C-H-Chien/Haptic_Belt_Navigation/EverythingOld/Julian-Valleyeason-May-6-2020-thesis defense.pdf

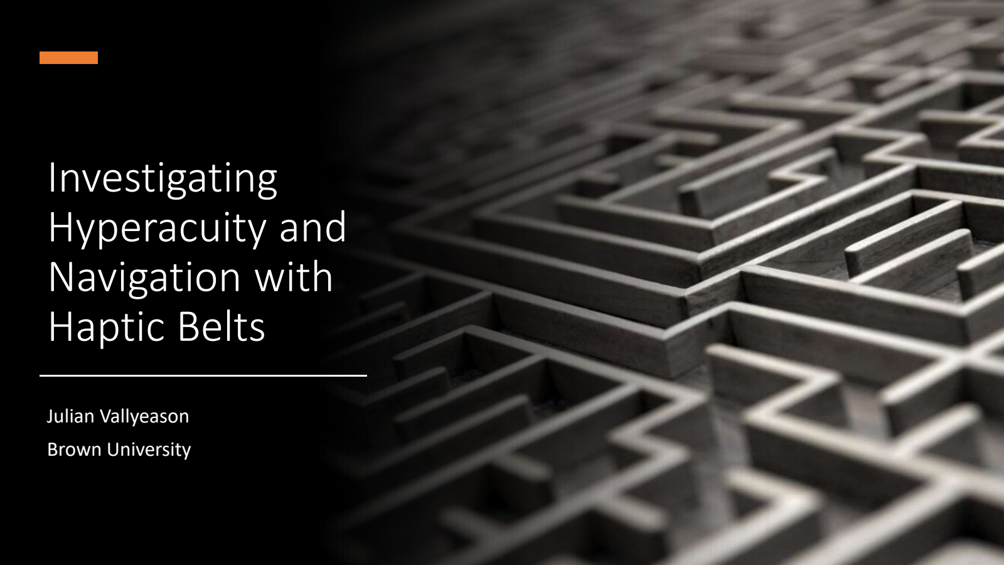
[picture p9: page 1]

# Investigating Hyperacuity and Navigation with Haptic Belts

Julian Vallyeason
Brown University

# Introduction

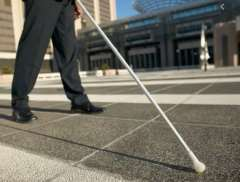
[picture p10: figure]
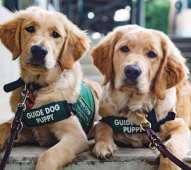
[picture p11: figure]

# Navigational Technologies Considerations

1. Possible intrusion into the existing capacity of a sensory node
2. Difficulty in distilling visual feedback into low-complexity data without information loss
3. Developing an encoding scheme that can be reliably learned and continuously provides sensory feedback
[1] https://thebark.com/content/raising-guide-dog-puppy
[2] https://brailleworks.com/free-white-cane/

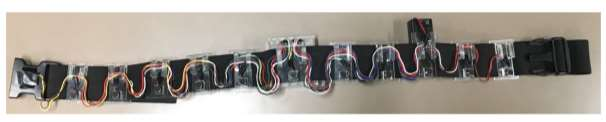
[picture p12: figure]

# Motivating Literature

# •Johannesson

et al.

### - Spatial tactile acuity of motors retained at distances as close as 13 mm apart

### - 92% accuracy for separations of 30 mm

# •Cholewiak et

al.

### - Examined detection threshold for vibration on 12 sites around the abdomen - People tend to interpret vibrations ‘relative to specific loci around the body’ (spine & navel)

•Pielot et al.

### - Individuals can interpolate vibrations of different intensities around their waist

Johannesson, O. I., Hoffmann, R., Valgeirsdottir, V. V., Unnoorsson, R., Moldoveanu, A., & Kristjonsson, .. (2017). Relative vibrotactile spatial acuity of the torso. Experimental brain research, 235(11), 3505–3515. https://doi.org/10.1007/s00221-017-5073-6

Cholewiak, Roger W., et al. “Vibrotactile Localization on the Abdomen: Effects of Place and Space.” Perception & Psychophysics, vol. 66, no. 6, 2004, pp. 970–987., doi:10.3758/bf03194989.

Pielot, Martin, et al. “Evaluation of Continuous Direction Encoding with Tactile Belts.” Haptic and Audio Interaction Design Lecture Notes in Computer Science, 2008, pp. 1–10., doi:10.1007/978-3-540-87883-4_1.

## Objective

Investigate the effect of
haptic belt motor density
and vibration strength on
vibratory perception of
direction

Examine the efficiency of
single-motor vs. vibrating a distribution of motors at
varying intensities

How are vibratory
perceptions translated into directions and navigation?

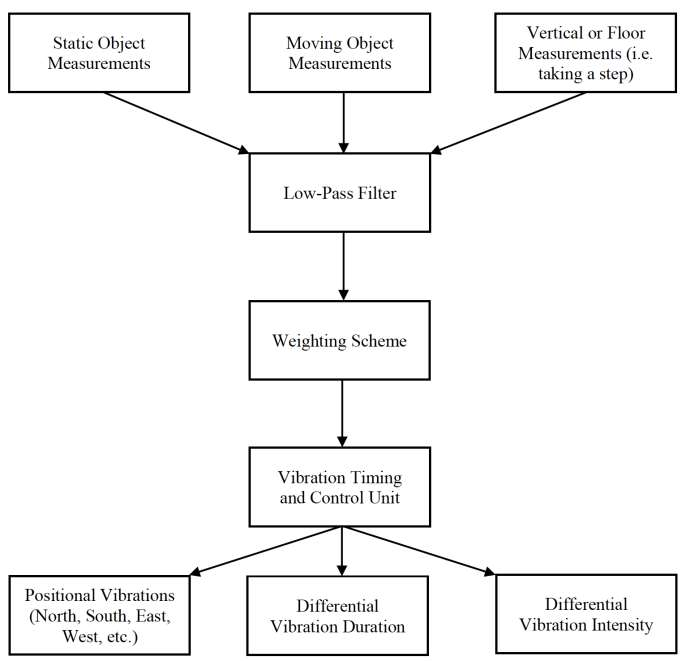
[picture p13: figure]

Adapted from; Katzschmann, R. K., Araki, B., & Rus, D. (2018). Safe Local Navigation for Visually Impaired Users with a Time-of-Flight and Haptic Feedback Device. IEEE Transactions on Neural Systems and Rehabilitation Engineering, 26 (3), 583–593. doi: 10.1109/tnsre.2018.2800665

Test 1: Vibratory Perception Test 2: Discrete Control
Test 3: Continuous Feedback

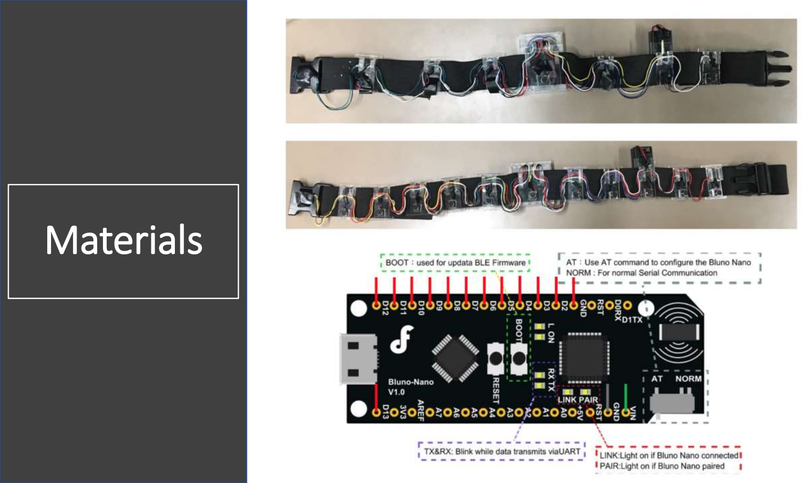
[picture p14: page 5]

# Materials

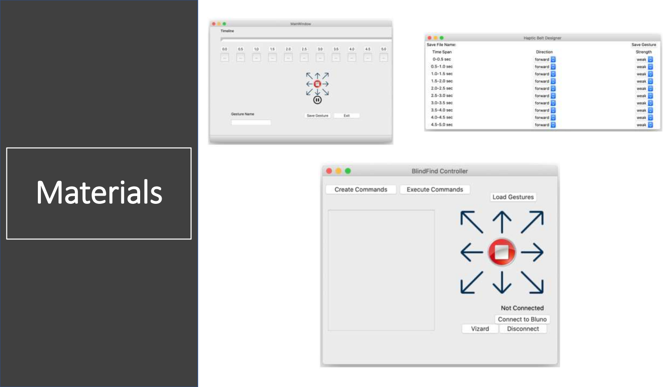
[picture p15: page 6]

# Materials

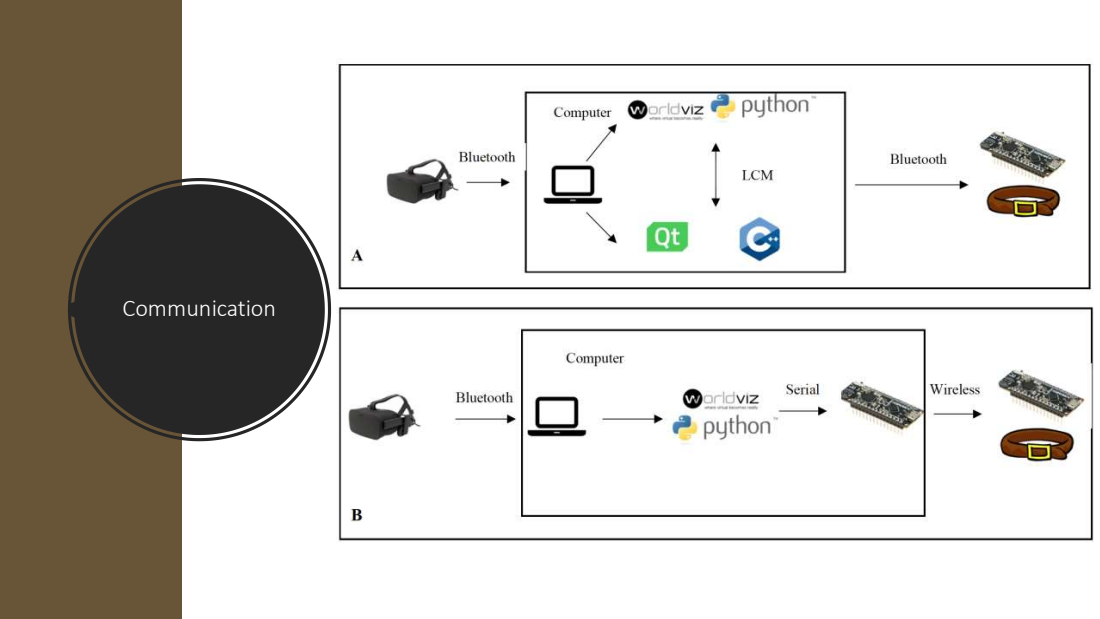
[picture p16: page 7]
Communication

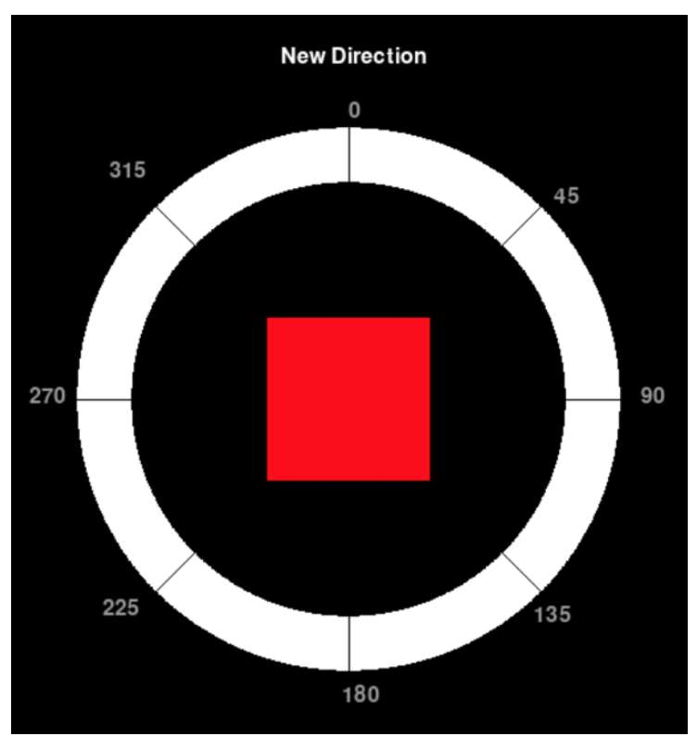
[picture p17: figure]

# Test 1: Vibratory Perception

- Examine single-motor
vibration (8-motor and 12-motor belt) and Gaussian
vibration scheme (12-motor belt)
- Subjects were told to click on the direction they feel best represents the
direction of vibration

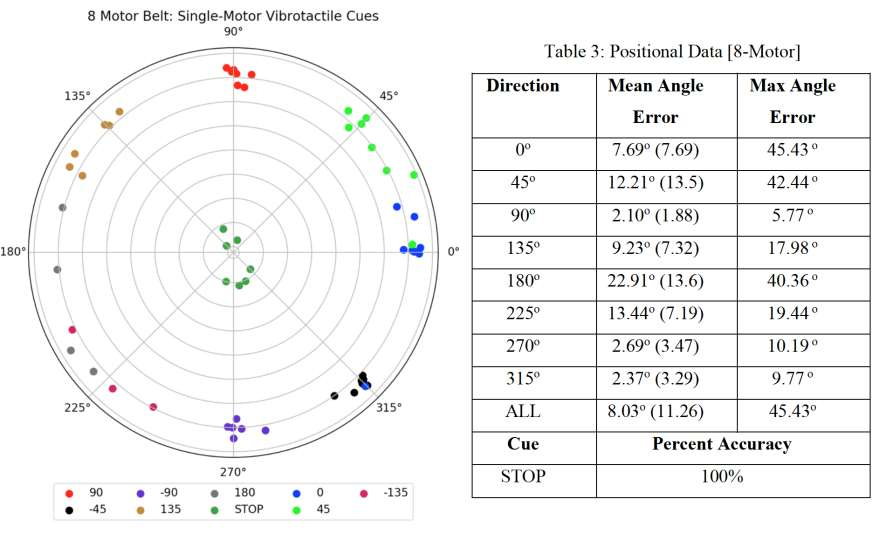
[picture p18: figure]

8-Motor Belt
Single-Motor Vibrations

# Test 1: Vibratory Perception

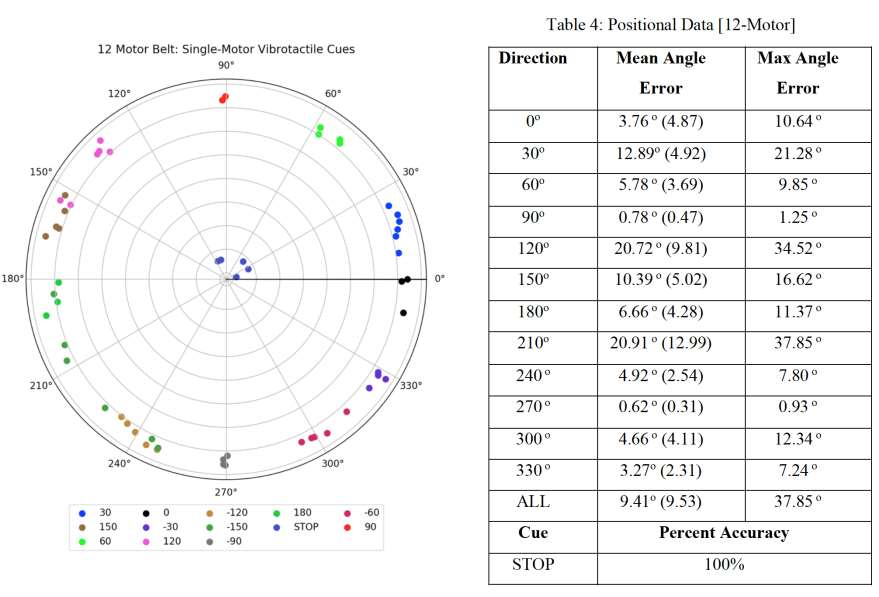
[picture p19: figure]

12-Motor Belt
Single-Motor Vibrations

# Test 1: Vibratory Perception

# Test 1: Vibratory

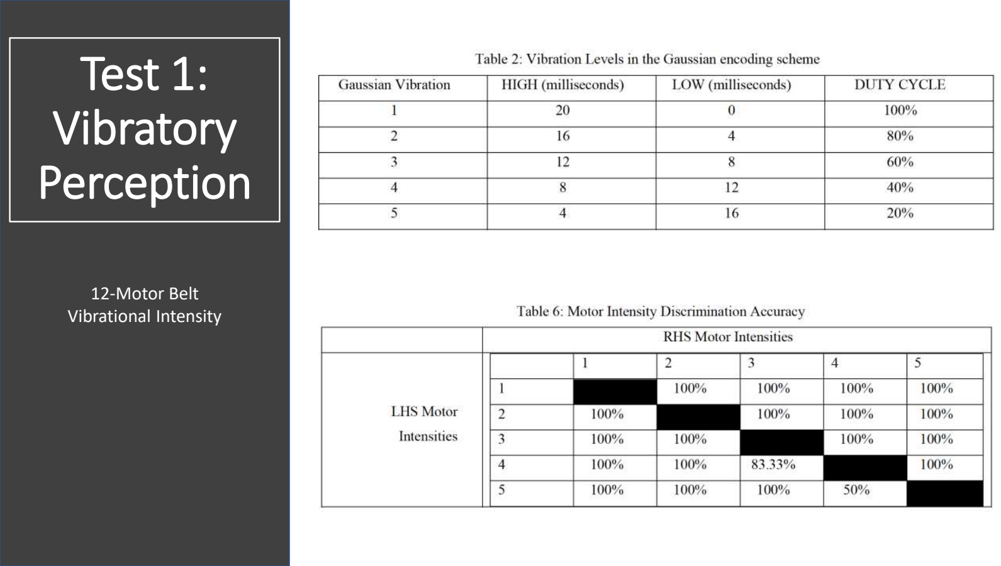
[picture p20: page 11]

# Perception

12-Motor Belt
Vibrational Intensity

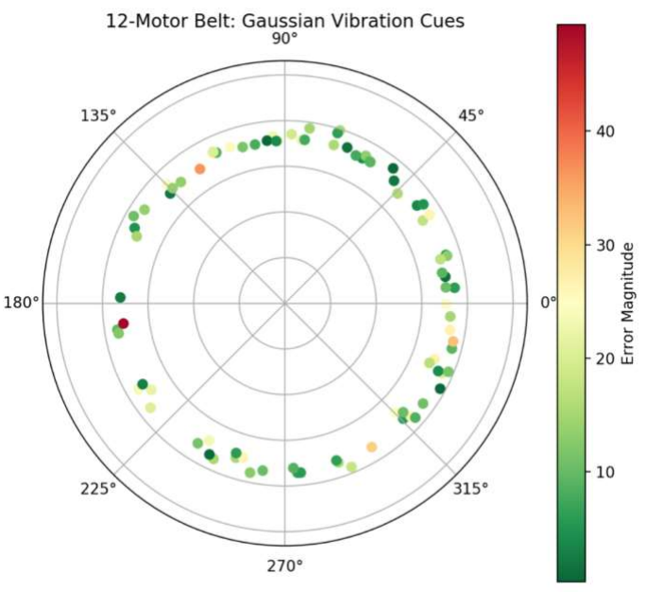
[picture p21: figure]

# Test 1: Vibratory Perception

12-Motor Belt
Gaussian Vibration Scheme

# Test 1:

# Vibratory Perception (Summary)

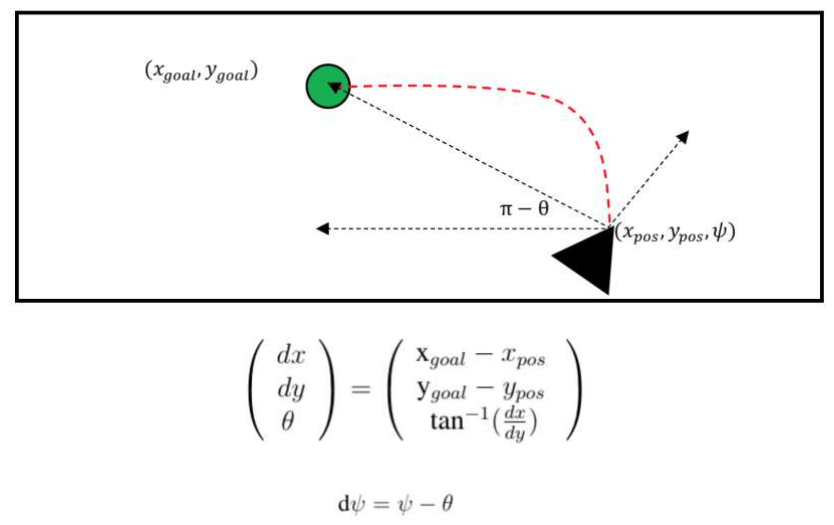
[picture p22: figure]

## 2) Discrete Control

## 3) Continuous Feedback

# Navigation Methods

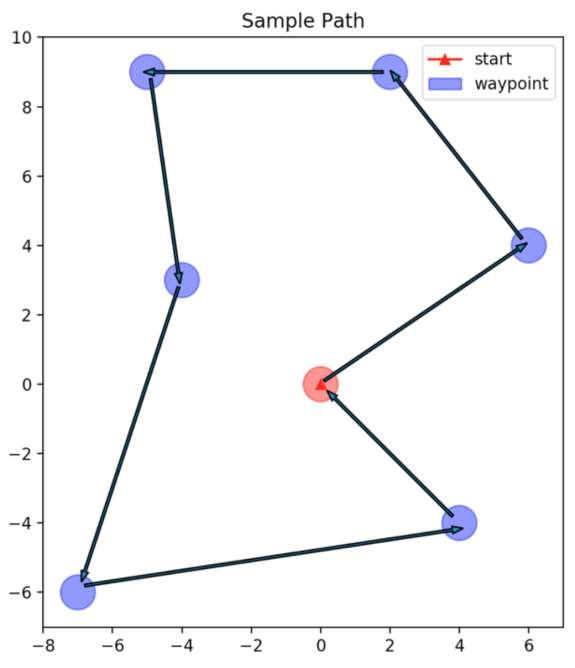
[picture p23: figure]

# Test 2: Discrete Control

- Navigate to 7 waypoints
receiving only an initial
signal from the current
point
- Keyboard-based navigation in virtual reality (W-A-S-D)

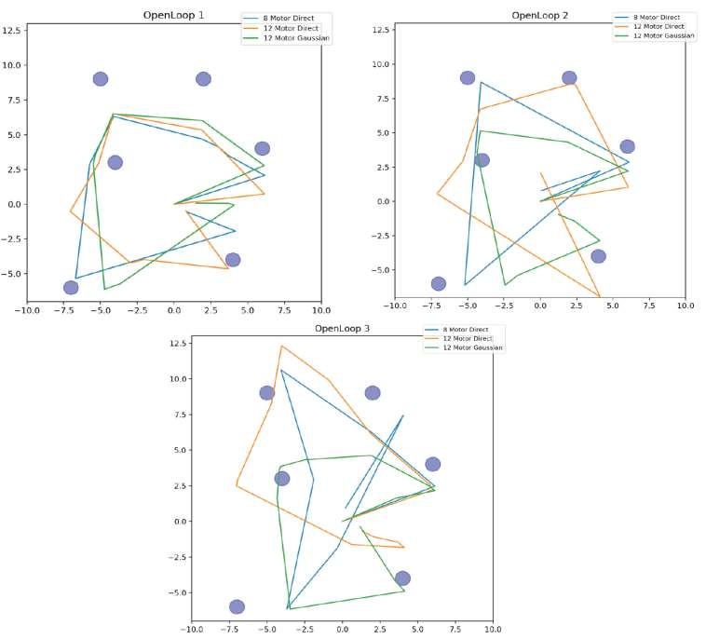
[picture p24: figure]

# Test 2: Discrete Control

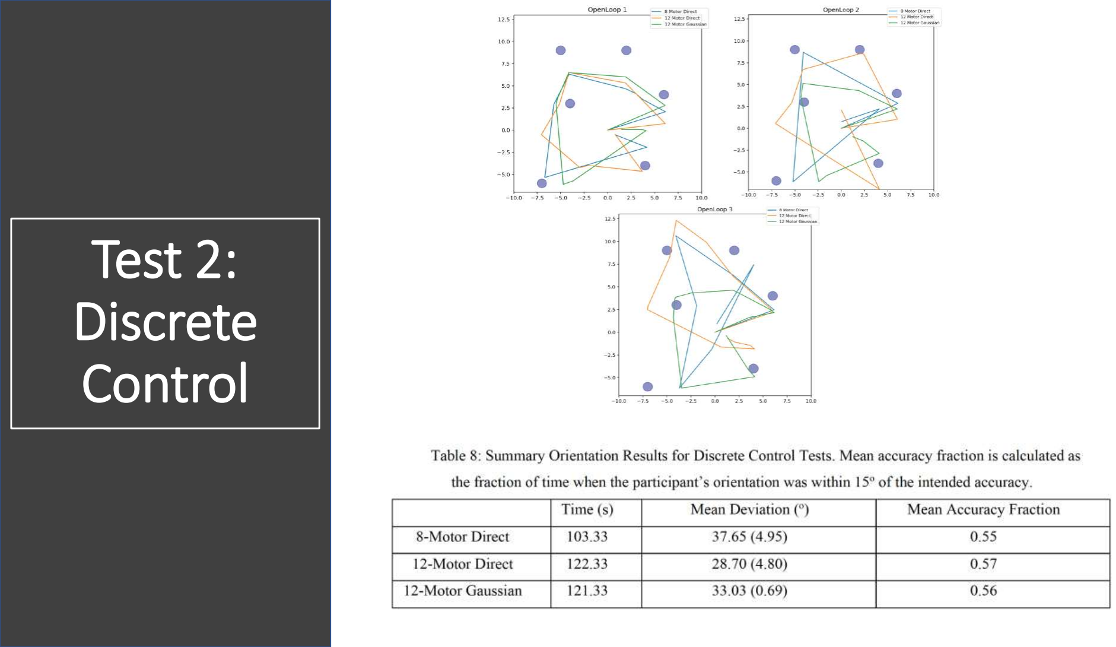
[picture p25: page 17]

# Test 2: Discrete Control

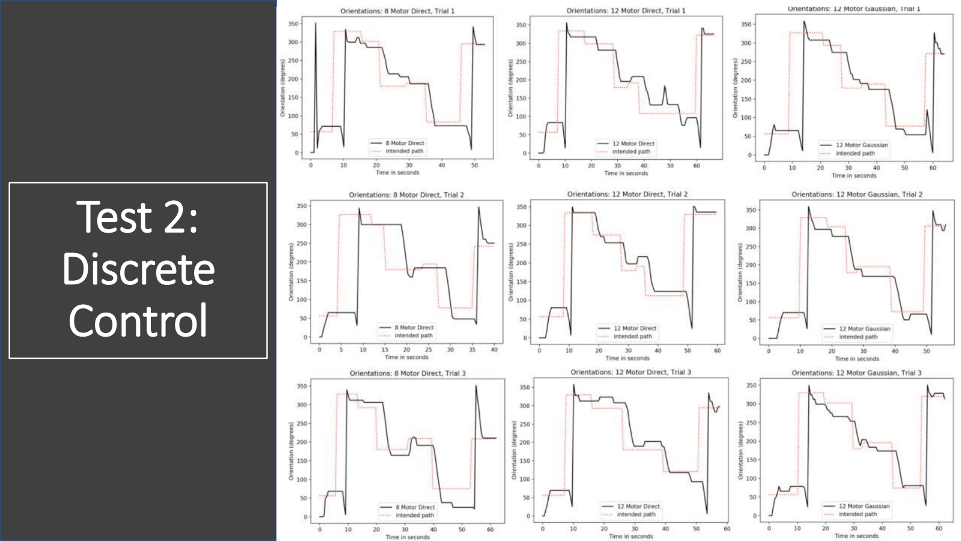
[picture p26: page 18]

# Test 2: Discrete Control

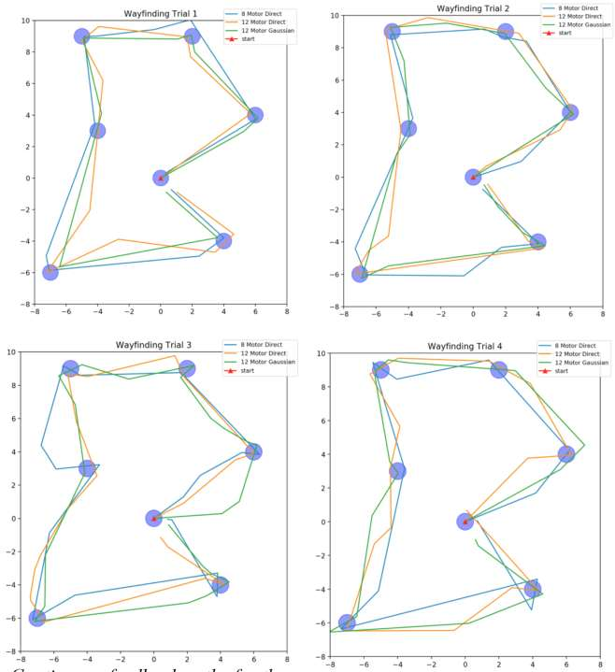
[picture p27: figure]

# Test 3: Continuous Feedback

- Continuously send
navigational vibrations
every 0.4 seconds
- Keyboard-based navigation in virtual reality (W-A-S-D)

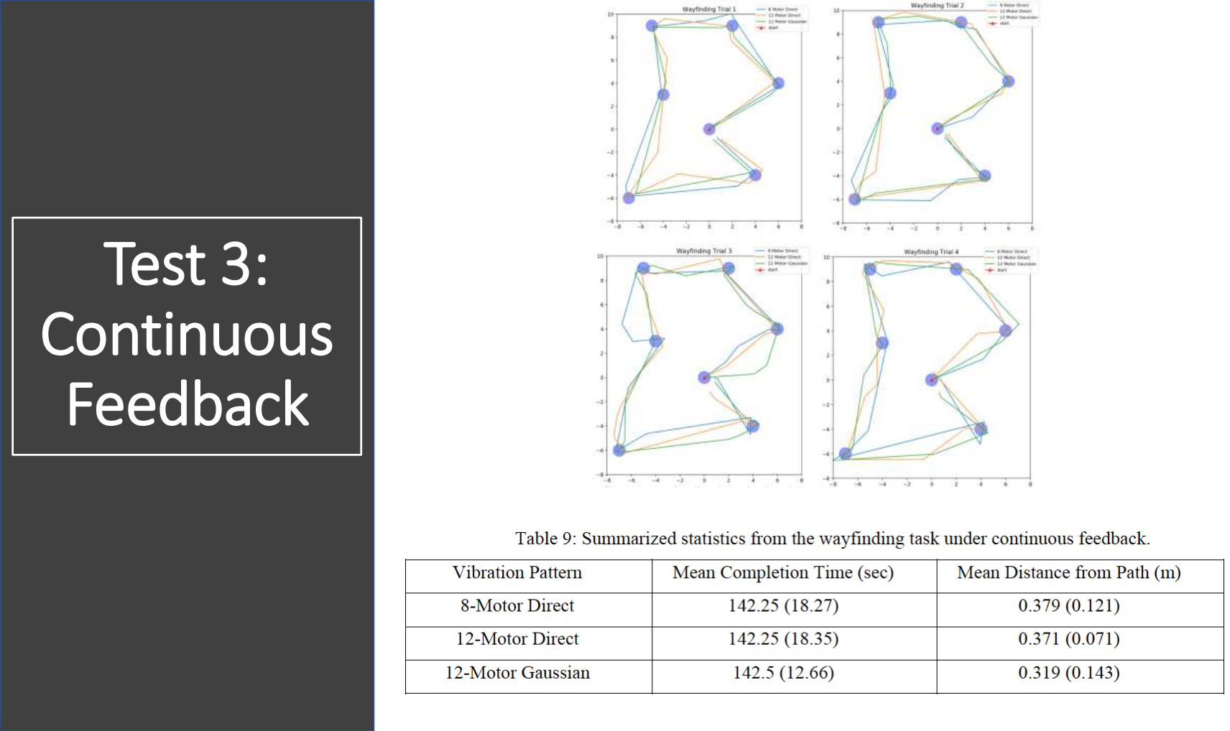
[picture p28: page 20]

# Test 3: Continuous Feedback

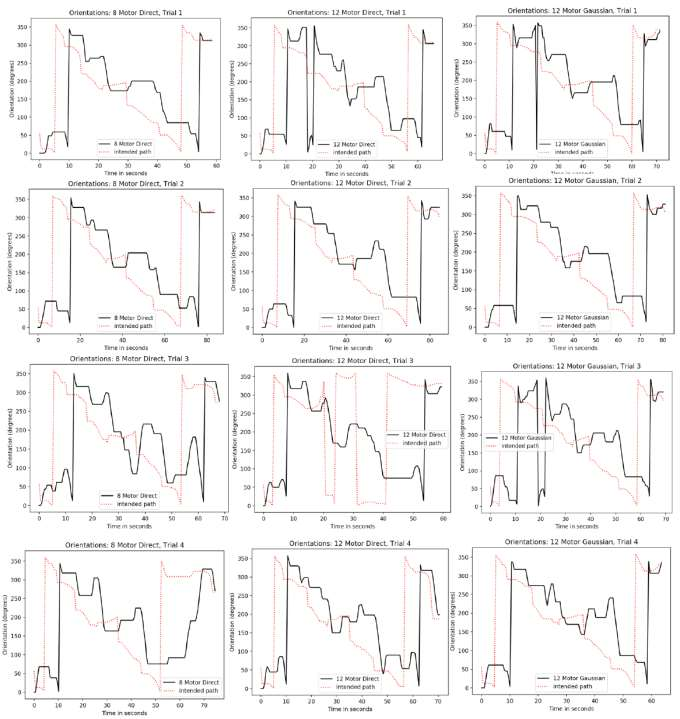
[picture p29: figure]

# Test 3: Continuous Feedback

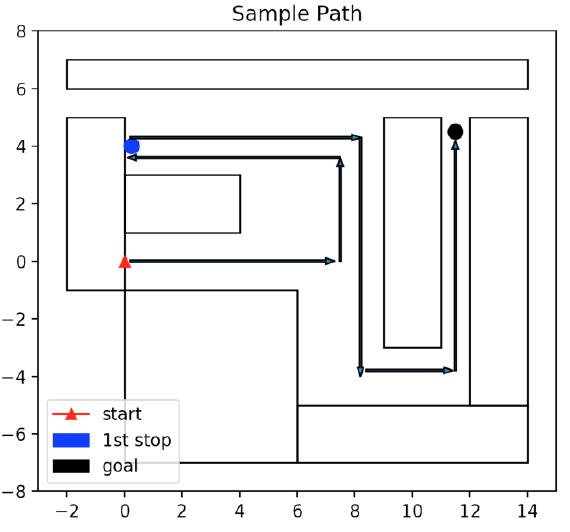
[picture p30: figure]

# Test 3: Continuous Feedback (2nd Task)

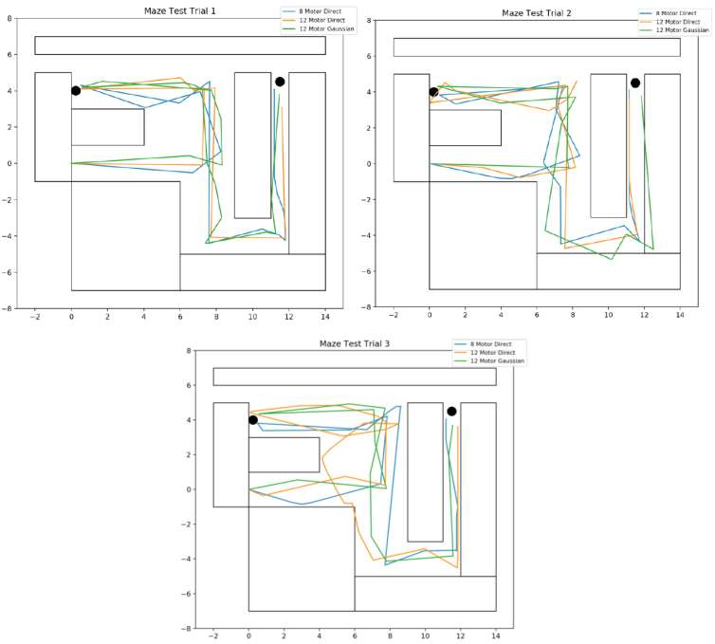
[picture p31: figure]

# Test 3: Continuous Feedback (2nd Task)

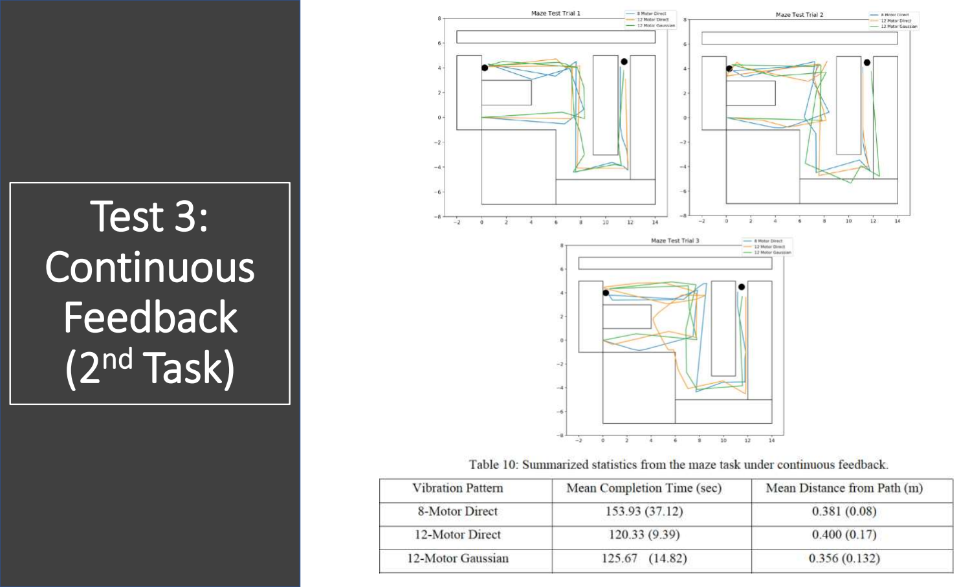
[picture p32: page 24]

# Test 3: Continuous Feedback (2nd Task)

# Conclusions

Investigate the effect of haptic belt motor density and vibration strength on vibratory perception of direction

Examine the efficiency of single-motor vs. vibrating a distribution of motors at varying intensities

How are vibratory perceptions translated into directions and navigation?

We see a slightly higher level of perception error with higher motor density,
but we have the ability to specify a wider range of directions.

The Gaussian vibration scheme appears to be comparable to the single-motor vibration scheme. Its performance led to a slightly lower distance error in the wayfinding task.

Vibratory perceptions can be translated into navigable directions. However, factors such as turning lag and persistent errors must be corrected.

## - Rotate the belt to different orientations to further test perception results - Effects of turning lag - Correction for persistent errors:

## - High waypoint density - 2 separate navigational schemes

- Incremental Turning Control
- Unguided Turning Control

## - 16-motor belt

# Future Steps

## - Viktor Ladics - Hongyi Fan - Dr. Brian Free - Professor Benjamin Kimia - LEMS and VEN lab

# Acknowledgements

# Investigating Hyperacuity and Navigation with Haptic Belts

## Julian Vallyeason Brown University
