C-H-Chien/Haptic_Belt_Navigation/Experiments/Navigation/00_Instructions/Open-ended-questions.png

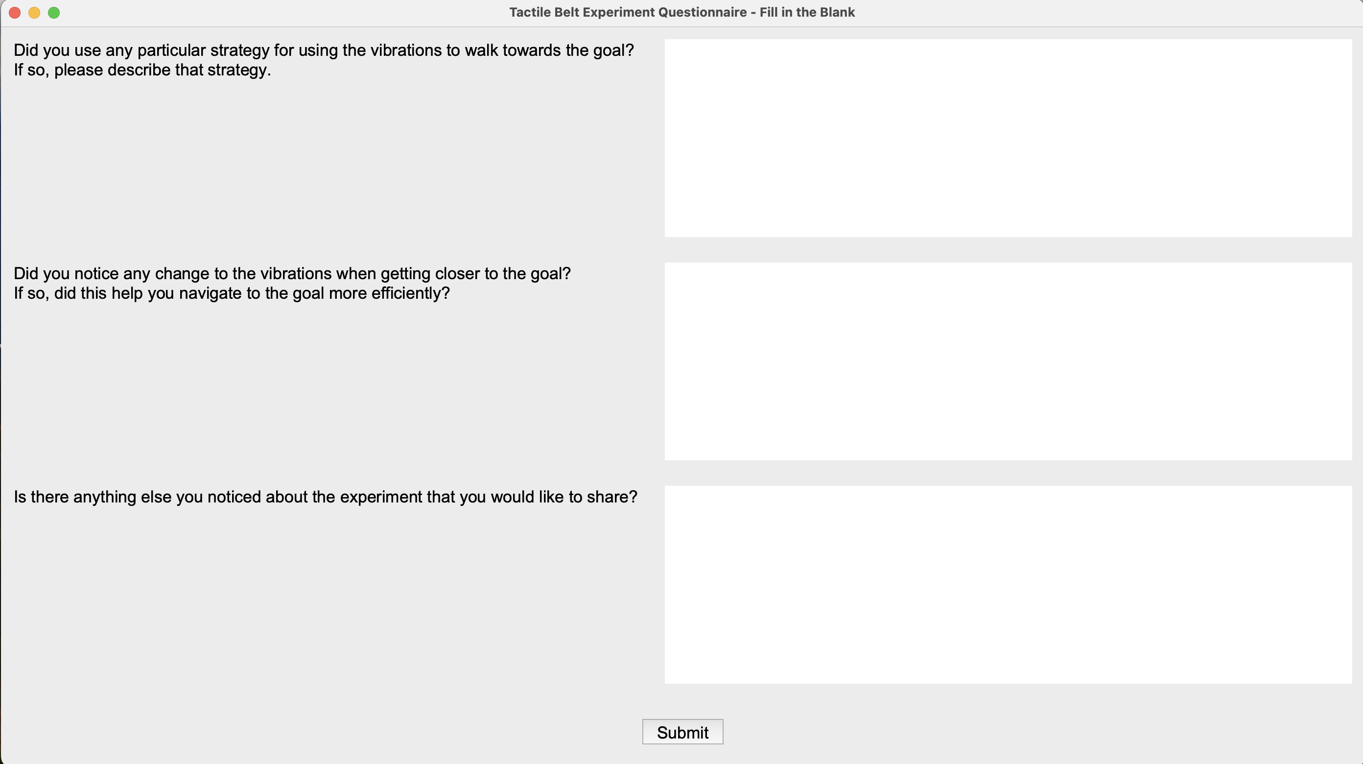
Experiments/Navigation/00_Instructions/Open-ended-questions.png
