C-H-Chien/Haptic_Belt_Navigation/Experiments/Navigation/00_Instructions/Scale-questions.png

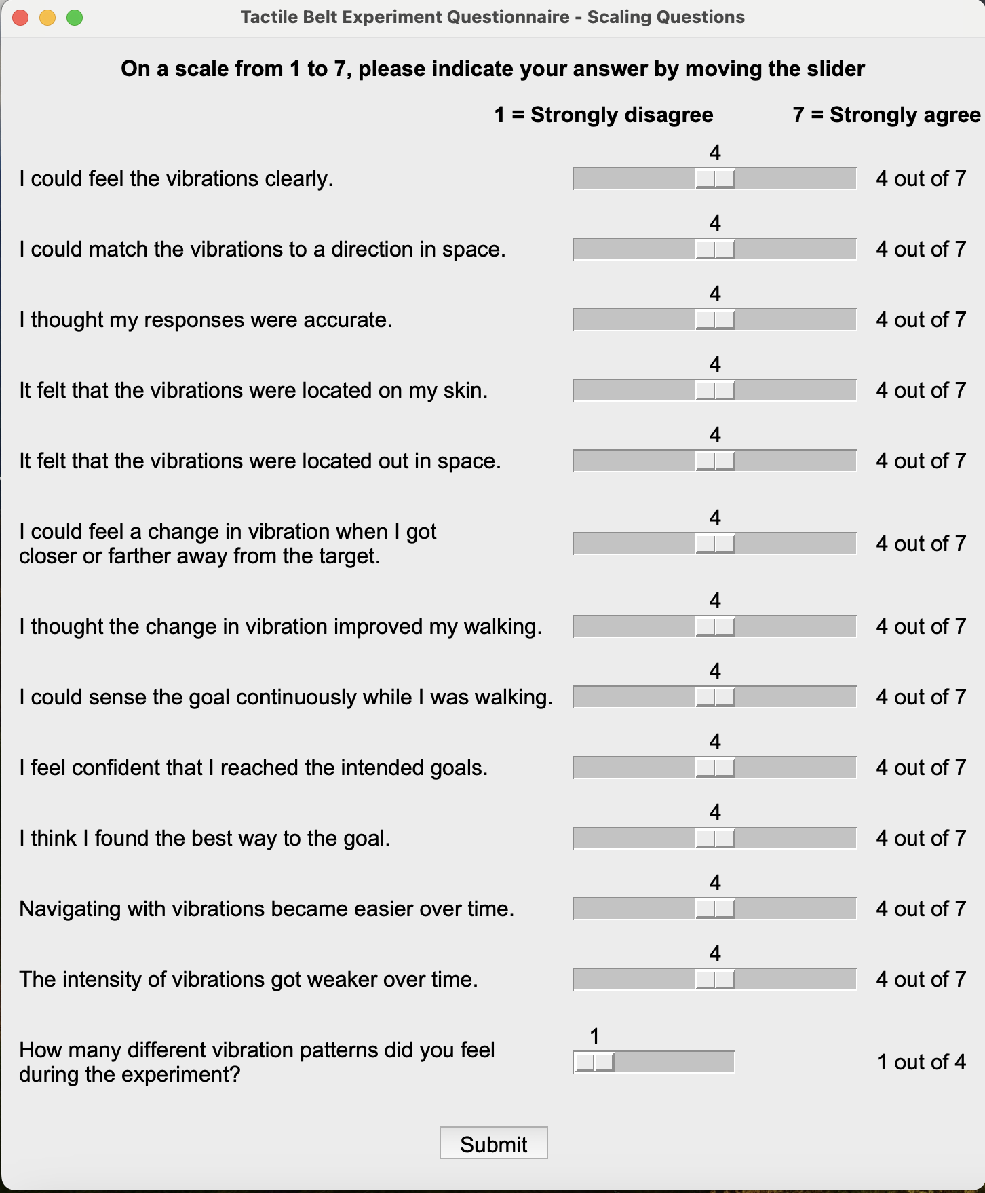
Experiments/Navigation/00_Instructions/Scale-questions.png
