C-H-Chien/Haptic_Belt_Navigation/Experiments/DirectionPerception/Belt_experiment_1.xlsx

Sheet: Tabelle1
SetUp | Block name | trial | Angles | repetition | number of motors | Intensity | estimated time [hh:mm:ss] | notes | Sina's recorded time
16 motor belt | Single vibration | 1 | 0 | 10 | 1 | highest | 0:00:50
 |  | 2 | 22.5 | 10 | 1 | highest | 0:00:50
 |  | 3 | 45 | 10 | 1 | highest | 0:00:50
 |  | 4 | 67.5 | 10 | 1 | highest | 0:00:50
 |  | 5 | 90 | 10 | 1 | highest | 0:00:50
 |  | 6 | 112.5 | 10 | 1 | highest | 0:00:50
 |  | 7 | 135 | 10 | 1 | highest | 0:00:50
 |  | 8 | 157.5 | 10 | 1 | highest | 0:00:50
 |  | 9 | 180 | 10 | 1 | highest | 0:00:50
 |  | 10 | 202.5 | 10 | 1 | highest | 0:00:50
 |  | 11 | 225 | 10 | 1 | highest | 0:00:50
 |  | 12 | 247.5 | 10 | 1 | highest | 0:00:50
 |  | 13 | 270 | 10 | 1 | highest | 0:00:50
 |  | 14 | 292.5 | 10 | 1 | highest | 0:00:50
 |  | 15 | 315 | 10 | 1 | highest | 0:00:50
 |  | 16 | 337.5 | 10 | 1 | highest | 0:00:50
 |  |  |  |  |  |  | block total | 0:13:20 | 0:13:38
 |  |  |  |  |  |  | break | 0:05:00
16 motor belt | Narrow Gaussian | 1 | 0 | 10 | 3 | adjacent | 0:00:50 |  |  | 3 adjacent motors narrow at all 16 position
 |  | 2 | 45 | 10 | 3 |  | 0:00:50 |  |  | 3 every other motors wide at all 16 position
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
