C-H-Chien/Haptic_Belt_Navigation/Experiments/DirectionPerception/Debriefing_questionnaires.docx

Debriefing questionnaires

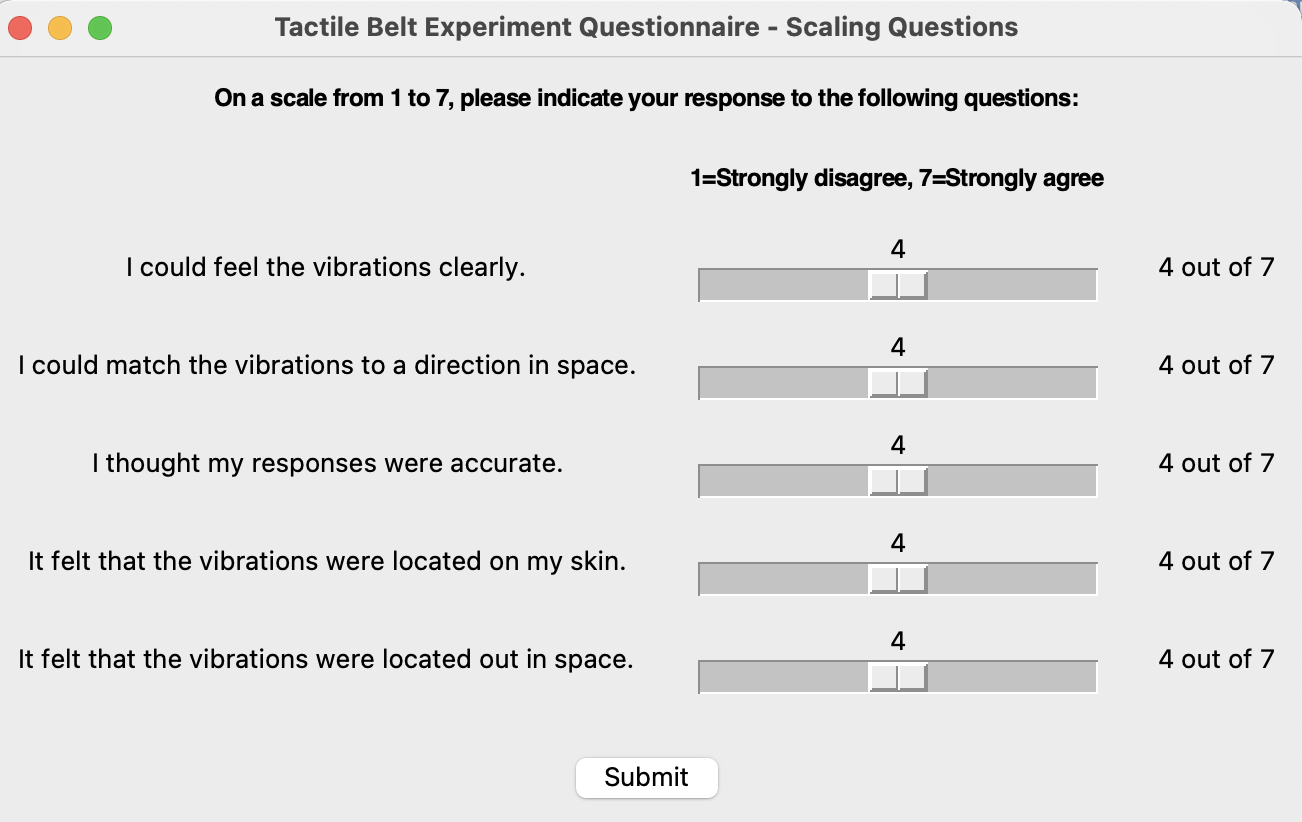
[picture p98: figure]
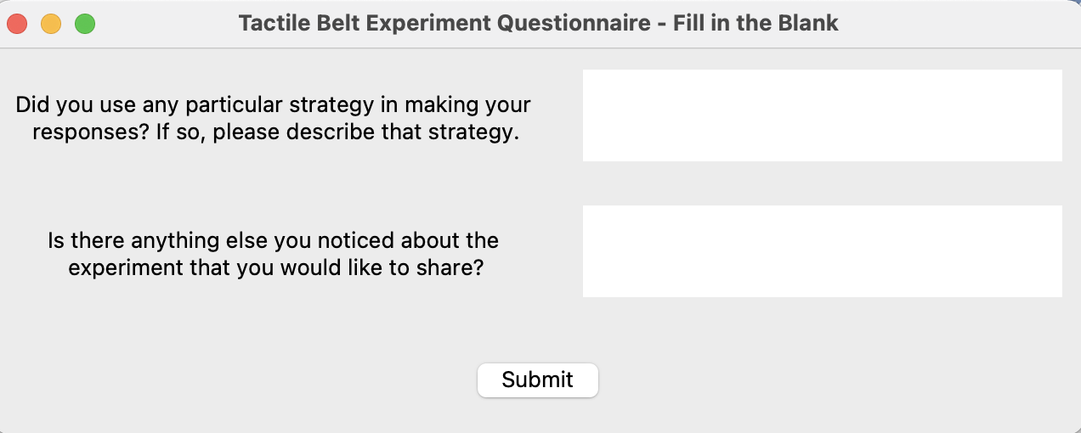
[picture p99: figure]
