C-H-Chien/Haptic_Belt_Navigation/Experiments/Navigation/01_Input-files/Session_02.csv

Trial | Block | Visual | Motor | DynamicClickRate | StartX | StartZ | OrientX | OrientZ | EgocentricAngle_0 | Distance_0 | WaypointX_0 | WaypointZ_0 | EgocentricAngle_1 | Distance_1 | WaypointX_1 | WaypointZ_1
0 | 1 | TRUE | FALSE | 0 | 0 | 0 | -7.071068 | -7.071067 | 225 | 4 | -1.75E-07 | 4 | 90 | 4 | -4 | 4
1 | 1 | TRUE | FALSE | 0 | 4 | 0 | 0.1731644 | -9.238795 | 270 | 8 | -3.391036 | 3.061468 | 135 | 8 | -0.3295672 | -4.329568
2 | 1 | TRUE | FALSE | 0 | 4 | 0 | -5.238795 | 3.826835 | 45 | 8 | -3.391036 | -3.061467 | 180 | 8 | 4 | 2.38E-07
3 | 1 | TRUE | FALSE | 0 | 0 | 0 | -7.071068 | -7.071067 | 315 | 4 | -4 | -3.50E-07 | 270 | 4 | -4 | 4
4 | 1 | TRUE | FALSE | 0 | 0 | 0 | -7.071068 | -7.071067 | 0 | 4 | -2.828427 | -2.828427 | 180 | 4 | -2.38E-07 | 2.38E-07
5 | 1 | TRUE | FALSE | 0 | -4 | 0 | 5.238795 | 3.826835 | 0 | 8 | 3.391036 | 3.061468 | 225 | 8 | 0.3295674 | -4.329568
6 | 1 | TRUE | FALSE | 0 | -4 | 0 | -11.07107 | -7.071067 | 45 | 4 | -4 | -4 | 90 | 8 | 4 | -4
7 | 1 | TRUE | FALSE | 0 | 4 | 0 | -3.071068 | -7.071067 | 315 | 8 | -4 | -6.99E-07 | 135 | 4 | -1.171573 | -2.828428
8 | 1 | TRUE | FALSE | 0 | 4 | 0 | 4 | -10 | 270 | 8 | -4 | -6.99E-07 | 90 | 4 | -4 | -4
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
