C-H-Chien/Haptic_Belt_Navigation/Experiments/Navigation/01_Input-files/Session_04.csv

Trial | Block | Visual | Motor | DynamicClickRate | StartX | StartZ | OrientX | OrientZ | EgocentricAngle_0 | Distance_0 | WaypointX_0 | WaypointZ_0 | EgocentricAngle_1 | Distance_1 | WaypointX_1 | WaypointZ_1
0 | 1 | TRUE | FALSE | 0 | -4 | 0 | -0.1731658 | 9.238795 | 315 | 8 | 3.391036 | 3.061468 | 225 | 8 | 0.3295674 | -4.329568
1 | 1 | TRUE | FALSE | 0 | 4 | 0 | -6 | -8.74E-07 | 0 | 8 | -4 | -6.99E-07 | 270 | 4 | -4 | 3.999999
2 | 1 | TRUE | FALSE | 0 | 0 | 0 | 3.826836 | -9.238794 | 90 | 4 | 3.695518 | 1.530734 | 135 | 8 | -3.695518 | 4.592202
3 | 1 | TRUE | FALSE | 0 | -4 | 0 | -0.1731639 | -9.238794 | 45 | 8 | 3.391037 | -3.061467 | 180 | 8 | -4 | 4.77E-07
4 | 1 | TRUE | FALSE | 0 | -4 | 0 | -0.1731639 | -9.238794 | 45 | 4 | -0.3044817 | -1.530734 | 135 | 4 | -1.835215 | 2.164784
5 | 1 | TRUE | FALSE | 0 | -4 | 0 | -4 | 10 | 0 | 4 | -4 | 4 | 270 | 8 | 4 | 4
6 | 1 | TRUE | FALSE | 0 | 0 | 0 | 3.826836 | -9.238794 | 315 | 4 | -1.530734 | -3.695518 | 225 | 4 | -3.061468 | 2.38E-07
7 | 1 | TRUE | FALSE | 0 | -4 | 0 | -0.1731639 | -9.238794 | 90 | 8 | 3.391036 | 3.061468 | 180 | 4 | -0.304482 | 1.530734
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
