C-H-Chien/Haptic_Belt_Navigation/Experiments/Navigation/01_Input-files/Session_05.csv

Trial | Block | Visual | Motor | DynamicClickRate | StartX | StartZ | OrientX | OrientZ | EgocentricAngle_0 | Distance_0 | WaypointX_0 | WaypointZ_0 | EgocentricAngle_1 | Distance_1 | WaypointX_1 | WaypointZ_1
0 | 1 | TRUE | FALSE | 0 | -4 | 0 | 5.238795 | 3.826835 | 315 | 8 | 3.391037 | -3.061467 | 135 | 8 | 0.3295693 | 4.329569
1 | 1 | TRUE | FALSE | 0 | 4 | 0 | -6 | -8.74E-07 | 0 | 8 | -4 | -6.99E-07 | 180 | 8 | 4 | -6.99E-07
2 | 1 | TRUE | FALSE | 0 | -4 | 0 | -14 | -8.74E-07 | 270 | 4 | -4 | 4 | 270 | 8 | 4 | 4
3 | 1 | TRUE | FALSE | 0 | 4 | 0 | -3.071068 | 7.071068 | 315 | 4 | 4 | 4 | 90 | 8 | -4 | 3.999999
4 | 1 | TRUE | FALSE | 0 | 4 | 0 | -5.238795 | 3.826835 | 45 | 8 | -3.391036 | -3.061467 | 225 | 8 | -0.3295686 | 4.329569
5 | 1 | TRUE | FALSE | 0 | 4 | 0 | -6 | -8.74E-07 | 45 | 4 | 1.171573 | -2.828427 | 225 | 4 | 1.171573 | 1.171573
6 | 1 | TRUE | FALSE | 0 | 0 | 0 | -10 | -8.74E-07 | 0 | 4 | -4 | -3.50E-07 | 90 | 4 | -4 | -4
7 | 1 | TRUE | FALSE | 0 | 0 | 0 | -10 | -8.74E-07 | 135 | 4 | 2.828427 | -2.828428 | 180 | 4 | -4.77E-07 | -4.77E-07
8 | 1 | TRUE | FALSE | 0 | 0 | 0 | 3.826834 | 9.238795 | 45 | 4 | -1.530734 | 3.695518 | 180 | 4 | 8.34E-07 | 4.77E-07
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
