C-H-Chien/Haptic_Belt_Navigation/Experiments/Navigation/01_Input-files/Session_06.csv

Trial | Block | Visual | Motor | DynamicClickRate | StartX | StartZ | OrientX | OrientZ | EgocentricAngle_0 | Distance_0 | WaypointX_0 | WaypointZ_0 | EgocentricAngle_1 | Distance_1 | WaypointX_1 | WaypointZ_1
0 | 1 | TRUE | FALSE | 0 | -4 | 0 | -7.826834 | 9.238795 | 270 | 8 | 3.391036 | 3.061468 | 225 | 8 | 0.3295674 | -4.329568
1 | 1 | TRUE | FALSE | 0 | -4 | 0 | 3.071066 | -7.071069 | 45 | 8 | 4 | 0 | 225 | 4 | 1.171573 | -2.828427
2 | 1 | TRUE | FALSE | 0 | 4 | 0 | -6 | -8.74E-07 | 270 | 4 | 4 | 4 | 90 | 8 | -4 | 3.999999
3 | 1 | TRUE | FALSE | 0 | 0 | 0 | -10 | -8.74E-07 | 90 | 4 | 4.77E-08 | -4 | 135 | 4 | 2.828427 | -1.171573
4 | 1 | TRUE | FALSE | 0 | -4 | 0 | -14 | -8.74E-07 | 180 | 4 | 0 | 0 | 0 | 4 | 4 | 0
5 | 1 | TRUE | FALSE | 0 | 4 | 0 | -6 | -8.74E-07 | 315 | 4 | 1.171573 | 2.828427 | 45 | 4 | -2.828427 | 2.828427
6 | 1 | TRUE | FALSE | 0 | 4 | 0 | -6 | -8.74E-07 | 0 | 8 | -4 | -6.99E-07 | 180 | 8 | 4 | -6.99E-07
7 | 1 | TRUE | FALSE | 0 | 4 | 0 | -5.238795 | -3.826834 | 315 | 8 | -3.391036 | 3.061468 | 135 | 8 | -0.3295672 | -4.329568
8 | 1 | TRUE | FALSE | 0 | 4 | 0 | 0.1731644 | -9.238795 | 315 | 8 | -3.391036 | -3.061467 | 225 | 8 | -0.3295686 | 4.329569
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
