C-H-Chien/Haptic_Belt_Navigation/Experiments/Navigation/age.png

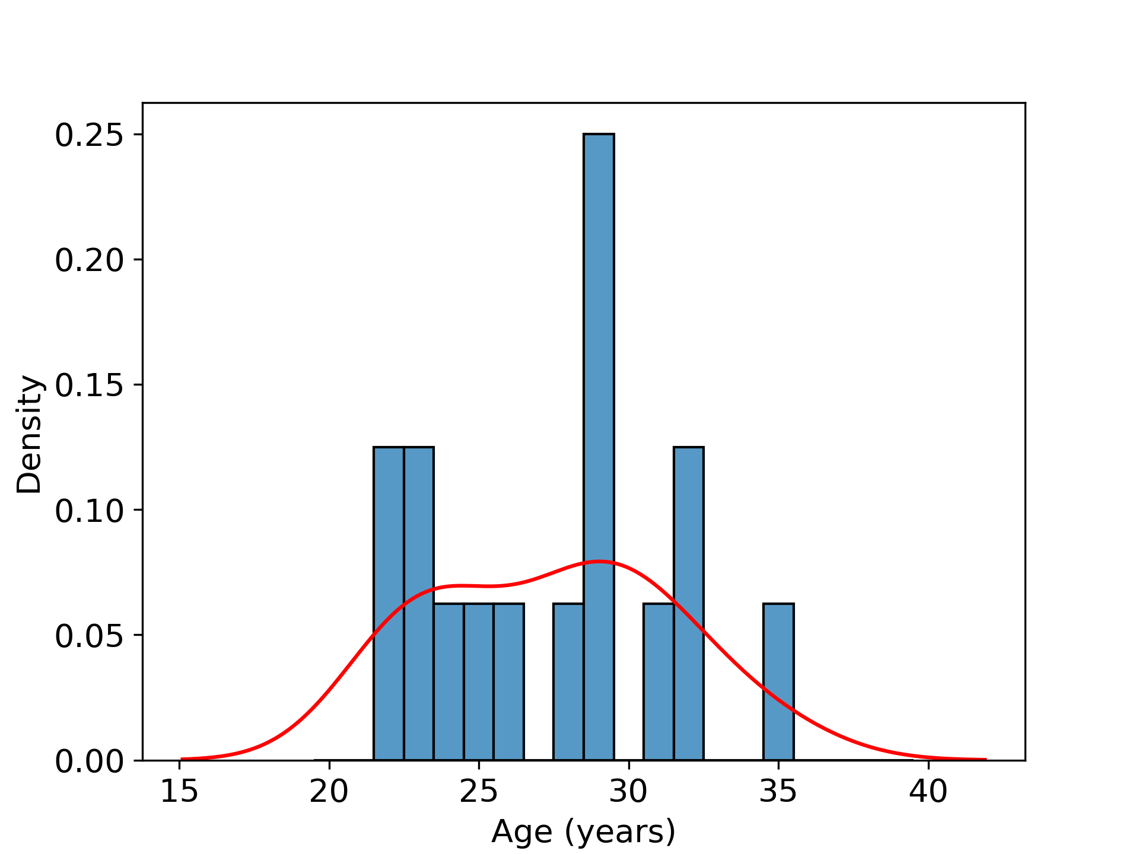
Experiments/Navigation/age.png
