C-H-Chien/Haptic_Belt_Navigation/Experiments/Navigation/gender.png

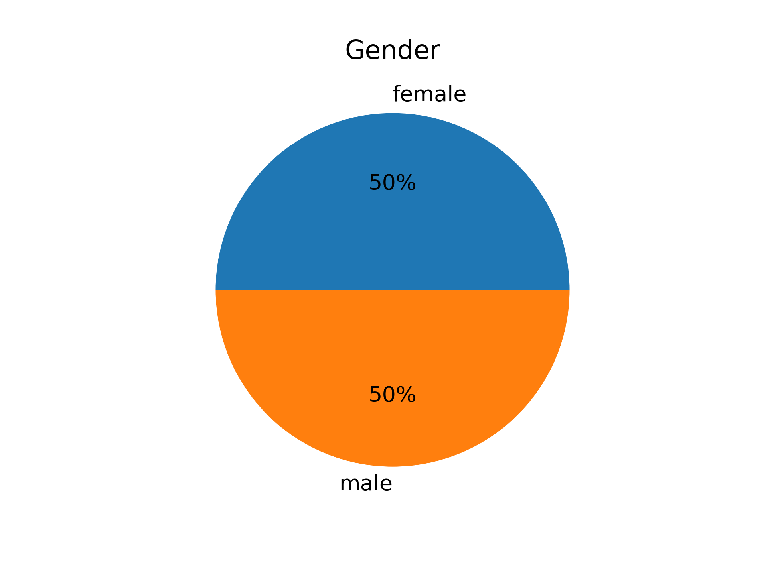
Experiments/Navigation/gender.png
