C-H-Chien/Haptic_Belt_Navigation/Experiments/Navigation/questionnaire_scale.png

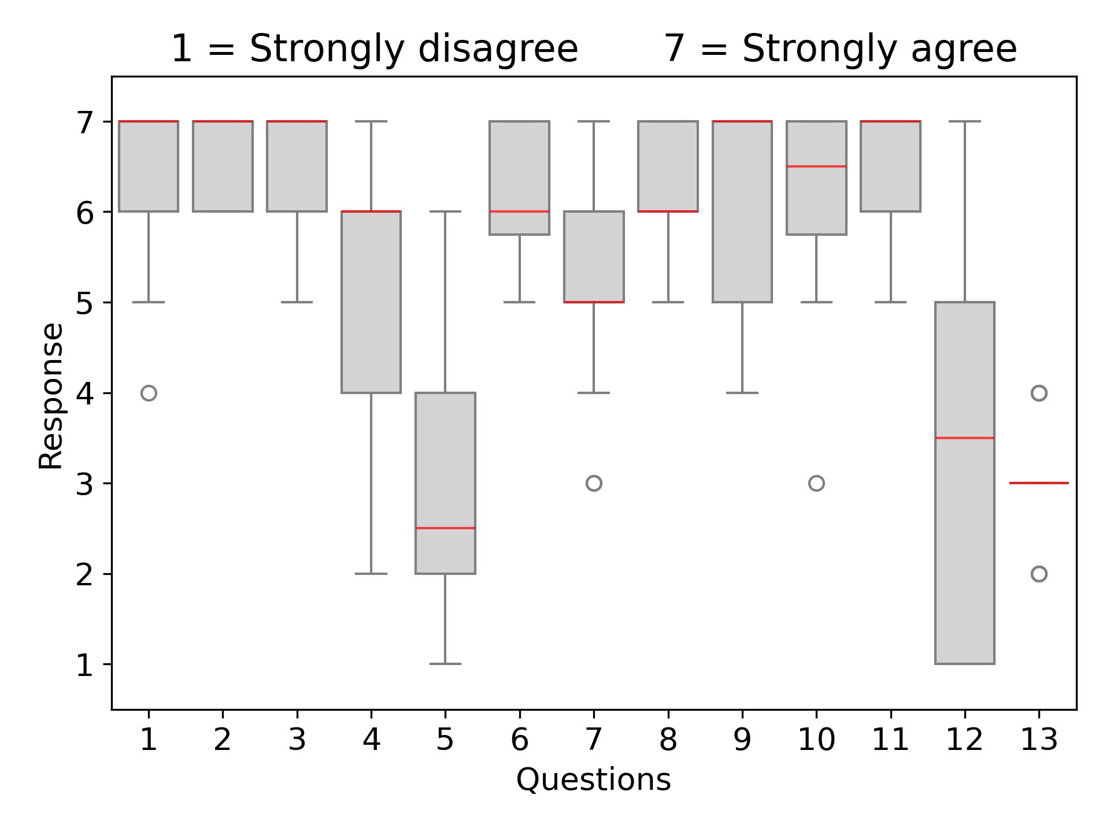
Experiments/Navigation/questionnaire_scale.png
