C-H-Chien/Haptic_Belt_Navigation/Experiments/Navigation/race2.png

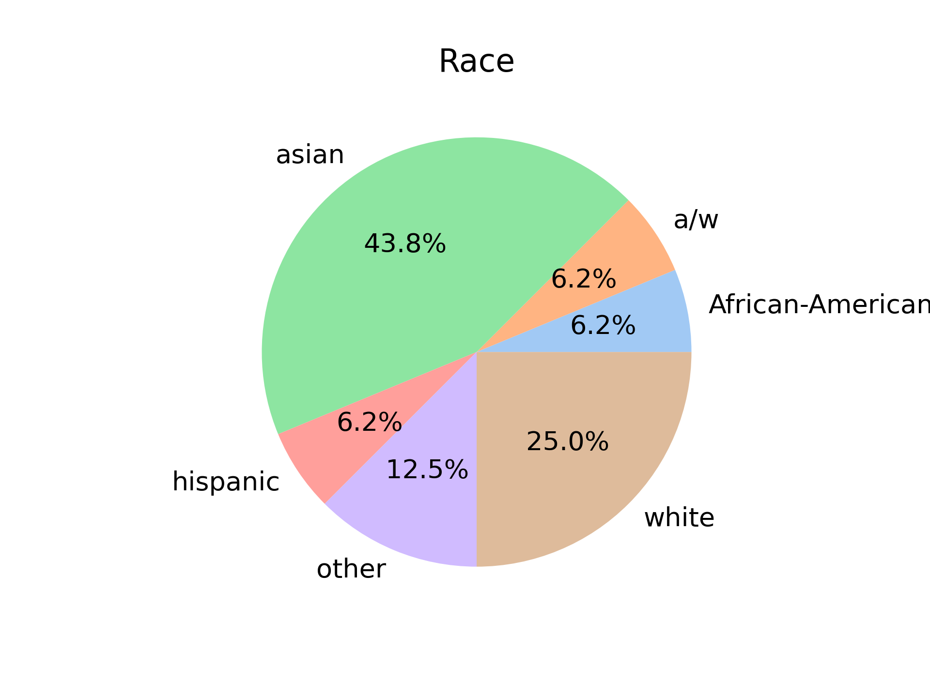
Experiments/Navigation/race2.png
