C-H-Chien/Haptic_Belt_Navigation/Experiments/Navigation/top_view_img.png

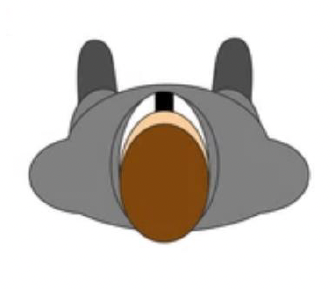
Experiments/Navigation/top_view_img.png
