C-H-Chien/Haptic_Belt_Navigation/Experiments/Navigation/fill_blank_gui.py

import tkinter as tk
import os
import sys

def submit_fill_in(subID, strategy_text, change_vibrations_text, other_observations_text, root):
    """Gather data from the UI, save it to a file, and close the application."""
    strategy = strategy_text.get("1.0", tk.END).strip()
    change_vibrations = change_vibrations_text.get("1.0", tk.END).strip()
    other_observations = other_observations_text.get("1.0", tk.END).strip()

    # Create folder if it doesn't exist
    folder_path = "experiment_responses"
    os.makedirs(folder_path, exist_ok=True)

    # Open the file and append the additional responses
    filename = f"response_text_{subID}.txt"
    with open(os.path.join(folder_path, filename), 'a') as file:
        file.write(f"Strategy Used: {strategy}\n")
        file.write(f"Vibration change: {change_vibrations}\n")
        file.write(f"Other Observations: {other_observations}\n")

    print("Response saved successfully!")
    root.destroy()  # Close the window

def main_fill_in(subID):
    root = tk.Tk()
    root.title("Tactile Belt Experiment Questionnaire - Fill in the Blank")

    #Font configuration
    question_font = ('Arial', 17)
    large_font = ('Arial', 17)

    # Text entry for strategies and observations
    tk.Label(root, text="Did you use any particular strategy for using the vibrations to walk towards the goal? \nIf so, please describe that strategy.", font=question_font, 
             justify="left").grid(row=0, column=0, padx=10, pady=10, sticky="NW")
    strategy_text = tk.Text(root, font=large_font, height=10, width=70)
    strategy_text.grid(row=0, column=1, padx=10, pady=10, sticky="W")

    tk.Label(root, text="Did you notice any change to the vibrations when getting closer to the goal? \nIf so, did this help you navigate to the goal more efficiently?", font=question_font, 
             justify="left").grid(row=1, column=0, padx=10, pady=10, sticky="NW")
    change_vibrations_text = tk.Text(root, font=large_font, height=10, width=70)
    change_vibrations_text.grid(row=1, column=1, padx=10, pady=10, sticky="W")

    tk.Label(root, text="Is there anything else you noticed about the experiment that you would like to share?", font=question_font, 
             justify="left").grid(row=2, column=0, padx=10, pady=10, sticky="NW")
    other_observations_text = tk.Text(root, font=large_font, height=10, width=70)
    other_observations_text.grid(row=2, column=1, padx=10, pady=10, sticky="W")

    

    # Submit button
    submit_btn = tk.Button(root, text="Submit", font=large_font, command=lambda: submit_fill_in(subID, strategy_text, change_vibrations_text, other_observations_text, root))
    submit_btn.grid(row=3, columnspan=2, pady=20)

    root.mainloop()

# Function to create pop-up for entering SubjectID
def get_subject_id():
    def on_submit():
        nonlocal subject_id
        subject_id = entry.get()
        root.destroy()

    subject_id = None
    root = tk.Tk()
    tk.Label(root, text="Enter Subject ID:").pack(side="top", fill="x", padx=20, pady=10)
    entry = tk.Entry(root)
    entry.pack(padx=20, pady=20)
    submit_button = tk.Button(root, text="Submit", command=on_submit)
    submit_button.pack(pady=10)
    root.mainloop()
    return subject_id

def get_subject_id():
    def on_submit():
        nonlocal subject_id
        subject_id = entry.get()
        root.destroy()

    subject_id = None
    root = tk.Tk()
    tk.Label(root, text="Enter Subject ID:").pack(side="top", fill="x", padx=20, pady=10)
    entry = tk.Entry(root)
    entry.pack(padx=20, pady=20)
    submit_button = tk.Button(root, text="Submit", command=on_submit)
    submit_button.pack(pady=10)
    root.mainloop()
    return subject_id

if __name__ == "__main__":
    
    if len(sys.argv) > 1:
        subID = sys.argv[1]
    else:
        subID = get_subject_id()
        if subID is None:
            print("No Subject ID provided.")
            sys.exit(1)

    main_fill_in(subID)
