C-H-Chien/Haptic_Belt_Navigation/(commit log)

2024-03-22 added code that stops the system and motor viberation when pygame window is closed
2024-03-22 added the code to prevent pygame from stuck
    [directionPerception.py]
2024-05-13 updated vibration pattern for limited time of respondence
    [constants.py, directionPerceptionImpulse.py]
2024-09-05 Fix degreeAngle for the Gaussian mode. Also add poster from made by Sina.
    [directionPerceptionGaussian.py]
2024-09-25 Add the code where the user can click the direction to control the motor vibration
    [directionPerceptionImpulse_manualControl.py]
2025-04-18 Adding Documents for experiments
    [Belt_experiment_1.xlsx]
2025-08-04 Adding Manual motor control script
2025-11-26 Adding Input files
    [Session_01.csv, Session_02.csv, Session_03.csv, Session_04.csv, Session_05.csv, Session_06.csv, Session_07.csv, Session_08.csv]
2025-11-27 Adding filtered data
    [Session_01_data.csv, Session_02_data.csv, Session_03_data.csv, Session_04_data.csv, Session_05_data.csv, Session_08_data.csv, Session_10_data.csv, Session_11_data.csv]
